KafuShoda/esp32-ecg-heart-rate-audio-monitor/images/phase-7/README.md

# Phase 7 Images

Photographs and screenshots documenting ECG continuity, stationary
heart-rate reliability, electrode disconnection, signal-quality
protection, recovery, and controlled movement testing.

## Test 1: Stationary Raw ECG Baseline

### `phase-7-01-complete-setup.jpeg`

Complete breadboard and electrode-cable setup used during Phase 7 testing.

### `phase-7-02-raw-baseline.jpeg`

Stationary raw ECG waveform obtained with all three new electrodes connected.

## Test 2: Ten-Minute Raw-Sample Continuity

### `phase-7-03-continuity-1-minute.png`

One-minute checkpoint showing 125 samples per second, a last-sample age
of 0 ms, and `STREAMING` status.

### `phase-7-04-continuity-5-minutes.png`

Five-minute checkpoint showing continued acquisition and 37,126
cumulative samples.

### `phase-7-05-continuity-10-minutes.png`

Ten-minute checkpoint showing 74,626 cumulative samples with acquisition
still continuously streaming.

## Test 3: Ten-Minute Stationary BPM and OLED Reliability

### `phase-7-06-bpm-1-minute.png`

One-minute checkpoint showing stable, internally consistent stationary
BPM and R–R readings.

### `phase-7-07-bpm-5-minutes.png`

Five-minute checkpoint showing continued BPM output without extreme
spikes or signal-loss messages.

### `phase-7-08-bpm-10-minutes.png`

Ten-minute checkpoint confirming that plausible BPM and R–R output
continued through the end of the stationary test.

## Test 4: Electrode Disconnection and Recovery

Test 4 was documented through two timed observation trials rather than
photographs. The combined results, individual-lead behavior, and recovery
times are recorded in
[`docs/phase-7-signal-reliability.md`](../../docs/phase-7-signal-reliability.md).

## Test 5: Signal-Quality Protection

Test 5 was documented through the tested source code and timed
observations. No screenshots were retained for this test.

The complete implementation and results are available in
[`docs/phase-7-signal-reliability.md`](../../docs/phase-7-signal-reliability.md).
