KafuShoda/esp32-ecg-heart-rate-audio-monitor/images/phase-3/README.md

# Phase 3 Images

Photographs and screenshots documenting the MAX30003 SPI wiring and successful microcontroller-to-sensor communication test.
