KafuShoda/esp32-ecg-heart-rate-audio-monitor/images/phase-2/README.md

# Phase 2 Images

Photographs and screenshots documenting the OLED header-pin soldering, wiring, I2C testing, troubleshooting, and successful display test.
