KafuShoda/esp32-ecg-heart-rate-audio-monitor/images/phase-1/README.md

# Phase 1 Images

Photographs documenting the ESP32 microcontroller setup and successful program upload.
