KafuShoda/esp32-ecg-heart-rate-audio-monitor/images/phase-1/successful-upload-blinking.png

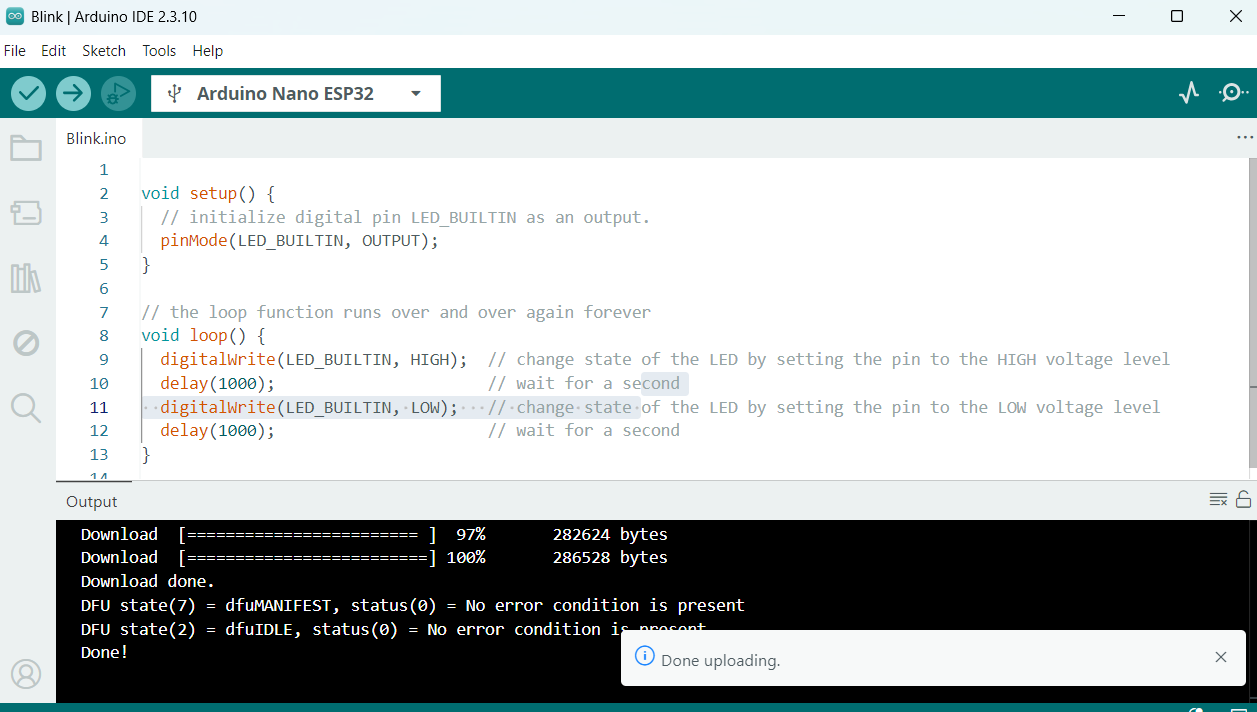
images/phase-1/successful-upload-blinking.png
