KafuShoda/esp32-ecg-heart-rate-audio-monitor/images/phase-6/phase-6-acquiring-screen.jpeg

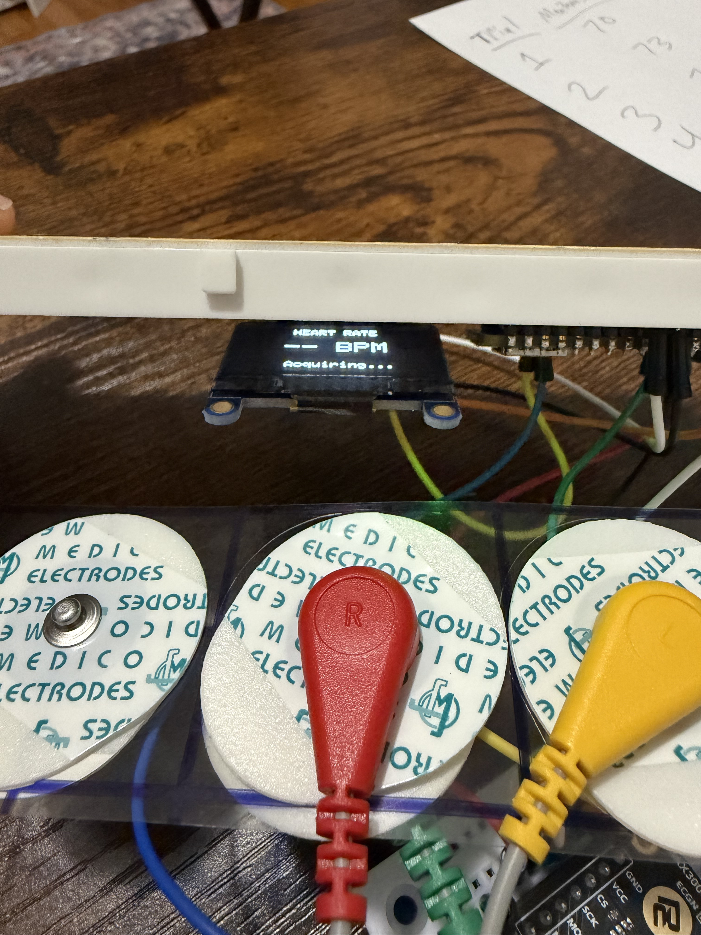
images/phase-6/phase-6-acquiring-screen.jpeg
