KafuShoda/esp32-ecg-heart-rate-audio-monitor/images/phase-2/oled-complete-setup.jpeg

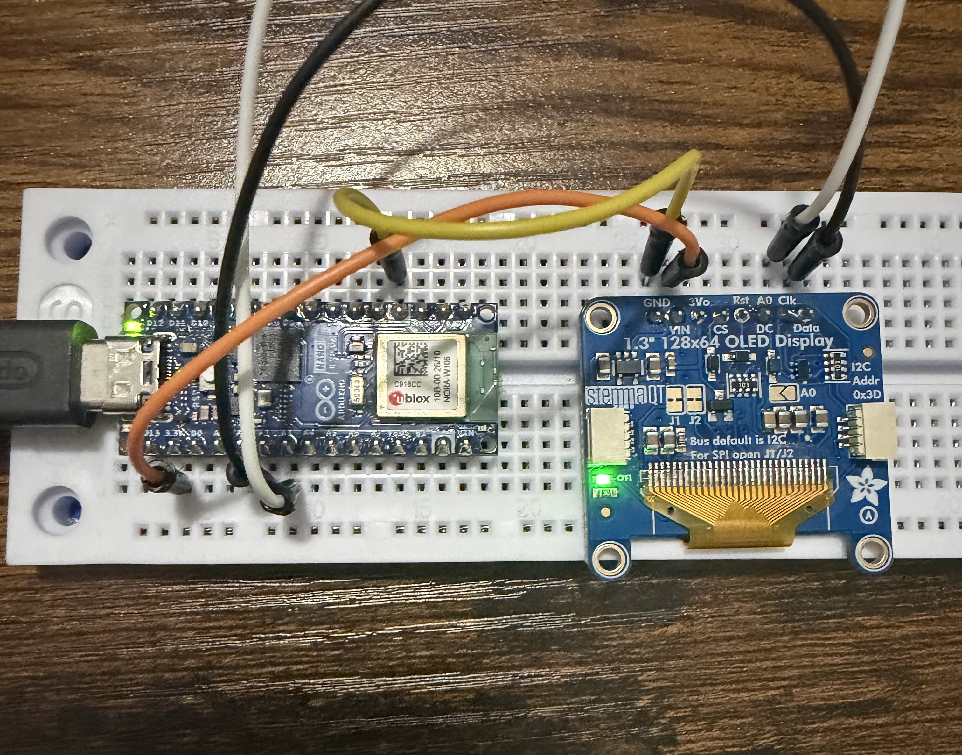
images/phase-2/oled-complete-setup.jpeg
