KafuShoda/esp32-ecg-heart-rate-audio-monitor/images/phase-2/oled-wiring-closeup.jpeg

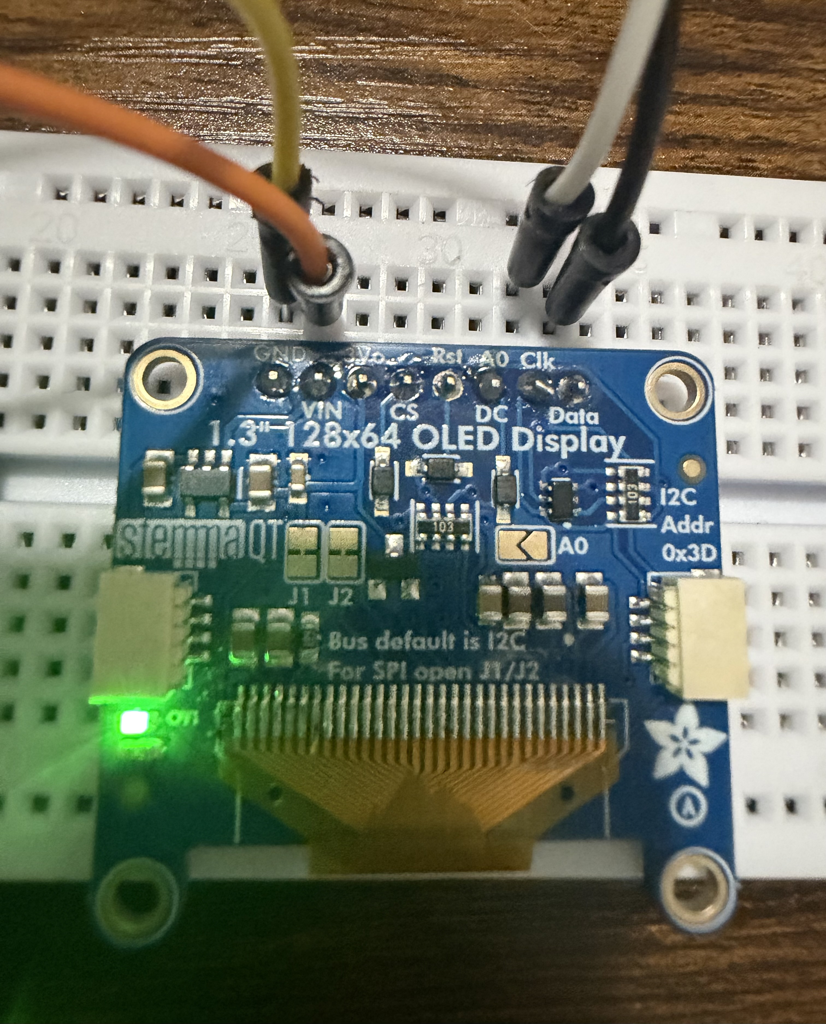
images/phase-2/oled-wiring-closeup.jpeg
