KafuShoda/esp32-ecg-heart-rate-audio-monitor/images/phase-3/max30003-wiring-closeup.jpeg

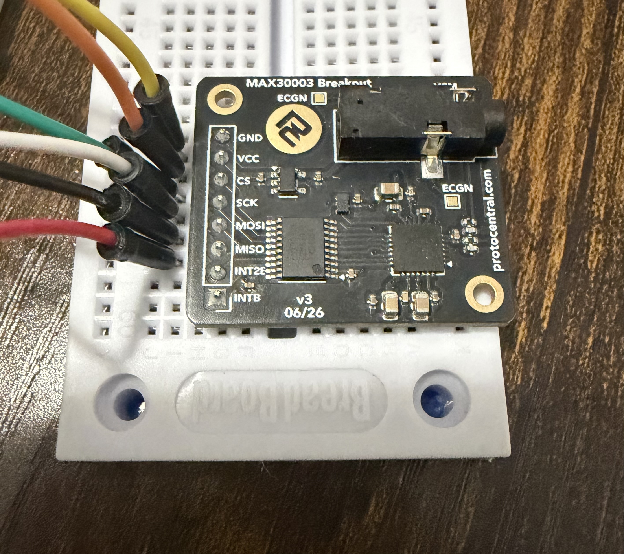
images/phase-3/max30003-wiring-closeup.jpeg
