KafuShoda/esp32-ecg-heart-rate-audio-monitor/images/phase-1/successful-blink-test.jpeg

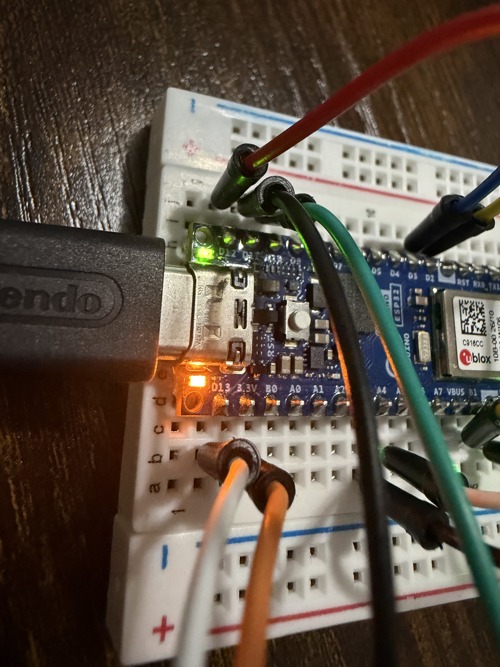
images/phase-1/successful-blink-test.jpeg
