KafuShoda/esp32-ecg-heart-rate-audio-monitor/(commit log)

2026-08-22 Add ESP32 microcontroller Blink test
    Add ESP32 microcontroller Blink test
2026-09-02 Document Phase 2 OLED assembly and testing
2026-09-02 Add OLED I2C scanner
2026-09-07 Update i2c-scanner.ino
    Add OLED I2C scanner using A2 and A3
2026-09-08 Add Phase 2 OLED assembly and test images
2026-09-08 Document Phase 2 OLED assembly and troubleshooting
2026-09-09 Add MAX30003 SPI communication test
2026-09-14 electrode placement photographs
2026-09-27 Update README.md
    Development progress, Phases 4-6 updated, and current status
