KafuShoda/esp32-ecg-heart-rate-audio-monitor/images/phase-4/phase-4-complete-system.jpeg

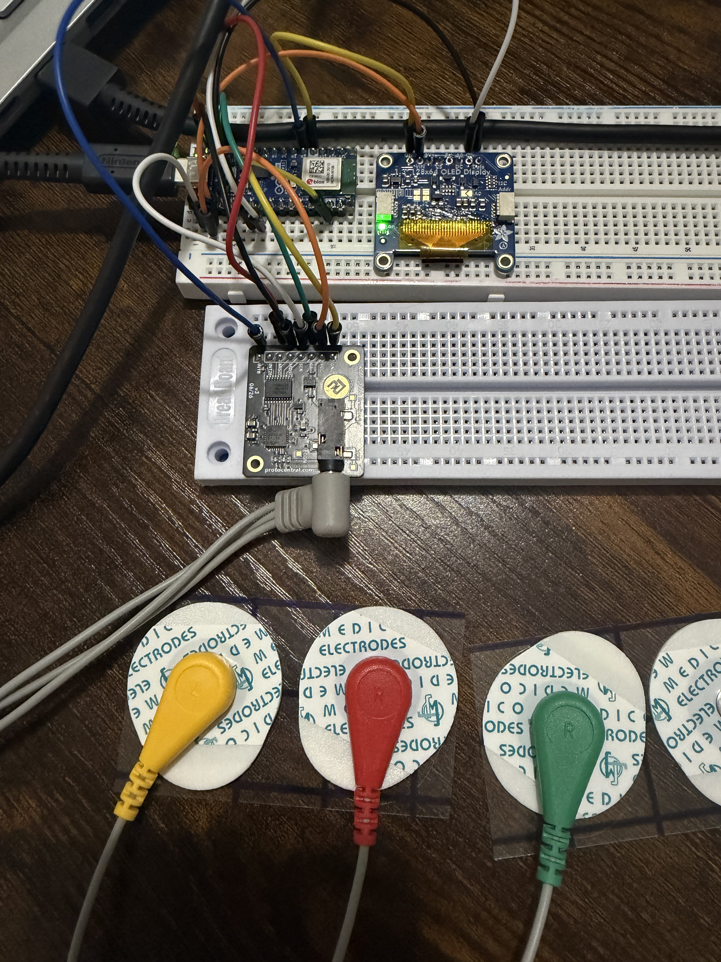
[picture p13: images/phase-4/phase-4-complete-system.jpeg]
images/phase-4/phase-4-complete-system.jpeg
